Sextant/utc-local-gps-ham-clock/(commit log)

2026-08-27 Add verified v12 firmware, documentation, tools, and project photos
    [BOM.csv]
2026-08-27 Correct microSD capacity guidance
2026-08-27 Document planned enclosure and battery power features
2026-08-27 Separate builder and maintainer documentation
    [BOM.csv]
